yj-c-oo/FPGA_AirDrawing_Video_Processing/v1-framebuffer/uvm/tb_brush_stroke_controller/docs/brush stroke ctrl 모듈 simulation 결과.docx

## 1. 각 테스트 케이스(TC)가 의미하는 것과 트랜잭션 수의 비밀

UVM 환경에서 Total Transactions는 스코어보드에서 compare() 함수가 실행된 횟수입니다. 즉, "하드웨어(DUT)가 실제로 선(Line)을 몇 번 그렸는가?"를 의미합니다.

펜을 뗀 프레임(pen_present = 0)은 하드웨어가 선을 그리지 않고 무시하므로 트랜잭션 개수에서 제외됩니다.

### 1) stroke_basic_test (기본 그리기 검증)

- 의미: 가장 단순한 단일 점(Dot) 그리기를 검증합니다. 시퀀스에서 딱 한 번 펜을 대고 그리는 프레임(pen_present=1, (100, 80))을 인가합니다.
- Total Transactions가 1인 이유: 프레임을 딱 1번 주었고, 하드웨어가 이에 반응해 (100,80) -> (100,80) 경로로 1개의 점을 그렸기 때문에 스코어보드에 1개만 찍힙니다.

### 2) stroke_connect_test (연속 선 그리기 검증)

- 의미: 사용자가 손을 떼지 않고 캔버스에 선을 슥 그리는 상황을 검증합니다. 즉, 이전 좌표와 현재 좌표가 끊어지지 않고 계속 이어지는지(연속 선 생성 로직) 확인하는 데 집중합니다.
- 시퀀스 구성: 아래와 같이 연속으로 4개의 프레임을 줍니다.
  1. Frame 1: (100,100)에 펜 대기
  2. Frame 2: (110,110)으로 이동
  3. Frame 3: (120,120)으로 이동
  4. Frame 4: (130,130)으로 이동
- Total Transactions가 4인 이유: 4번 모두 펜이 눌려있었으므로(pen_present=1), 하드웨어는 다음과 같이 총 4번 선을 그립니다.
  5. 100,100 -> 100,100 (첫 점)
  6. 100,100 -> 110,110 (이전 점과 이음)
  7. 110,110 -> 120,120 (이전 점과 이음)
  8. 120,120 -> 130,130 (이전 점과 이음) 따라서 실제 동작 횟수인 4개가 기록됩니다.

### 3) stroke_penup_test (펜 업/다운 및 초기화 검증)

- 의미: 그리다가 펜을 완전히 떼었다가(pen_present=0), 새로운 곳에 다시 펜을 대고 그릴 때 이전 좌표 버퍼가 잘 초기화되는지 검증합니다. 이전 좌표를 질질 끌고 와서 엉뚱한 사선이 그려지는 하드웨어 버그를 예방합니다.
- 시퀀스 구성: 총 3개의 프레임을 순서대로 줍니다.
  - Frame 1: (100,100)에 그리기 (pen=1)
  - Frame 2: (100,100)에서 손 떼기 (pen=0)
  - Frame 3: (200,200)에 새로 그리기 (pen=1)
- Total Transactions가 2인 이유: 2번째 프레임은 pen=0이라 하드웨어가 아웃풋을 내지 않고 스킵합니다. 따라서 실제로 선을 그린 동작은 Frame 1과 Frame 3 뿐이므로 2개만 트랜잭션으로 잡힙니다.

### 4) stroke_eraser_test & stroke_size_test (지우개 및 브러시 크기 검증)

- 의미:
  - eraser_test: 지우개 모드(sw_eraser=1)일 때 색상이 강제로 투명/검은색(4'b0000)으로 바뀌어 출력되는지 확인합니다.
  - size_test: 브러시 크기 조절(sw_size)에 따라 하드웨어가 렌더링 영역(반경 line_radius, 임계값 line_threshold)을 올바르게 계산해서 굵은 선을 그리는지 확인합니다.
- Total Transactions 수: 시퀀스 내부에서 프레임을 2번씩 쏘아주며, 펜이 모두 눌려있는 상태이므로 각각 2개씩의 동작을 검증하게 됩니다.

### 5) stroke_random_test (무작위 탐색 검증 - 250개)

- 의미: 펜의 상태, 좌표, 색상, 지우개 여부, 크기 등을 무작위($urandom)로 조합하여 하드웨어가 예상치 못한 예외 상황(Corner case)에서 오동작하거나 뻗지 않는지 확인하는 난수 기반 검증입니다.
- Total Transactions가 약 125개 내외인 이유: 시퀀스에서 총 repeat(250) 번 무작위 프레임을 던집니다. 펜 입력 여부(pen_present) 역시 0과 1이 대략 반반 확률로 결정되므로, 실제 펜이 눌려 선이 그려진 평균 125개 내외의 트랜잭션만 스코어보드에 도달하게 됩니다.

### 6) stroke_stress_test (스트레스/부하 검증 - 10000개)

- 의미: 하드웨어에 쉬지 않고 엄청난 양의 데이터를 쏟아부었을 때, 내부 버퍼가 넘치거나(Overflow) 타이밍 프로토콜이 깨지지 않는지 한계 성능을 시험하는 검증입니다.
- 시퀀스 구성: 무려 repeat(10000) 번 동안 연속해서 펜을 대고(pen_present=1) 무작위 좌표를 계속 던집니다.
- Total Transactions가 10000인 이유: 10000번의 프레임 요청 동안 펜을 한 번도 떼지 않고 계속 꾹 눌러 그렸기 때문에 하드웨어가 정직하게 10000번 그리기를 수행하여 10000개의 트랜잭션이 모두 정상 검증됩니다.
