yj-c-oo/FPGA_AirDrawing_Video_Processing/v1-framebuffer/uvm/tb_bbox_center_accum/docs/Bbox coverage 구성.docx

Coverpoint | 검증 내용
cp_position | 중심 / 가장자리 / 모서리 위치
cp_size | Small / Medium / Large 크기
cp_width / cp_height | 가로·세로 길이 구간
cp_pixel_count | Empty / Low / Valid / Huge 픽셀 수
cp_pen_type | Pen 인식 여부 (Threshold 기준)
cp_overflow | 화면 경계 Overflow 검증
cp_erosion | 3픽셀 Noise 제거(침식) 동작

Cross | 검증 목적 | Ignore Bin
cc_pos_size | 위치별 Marker 크기 검증 | Corner + Small 조합 제외 (구조적으로 불가능)
cc_pos_overflow | 위치에 따른 Overflow 검증 | Corner + Normal Overflow 제외 (수학적으로 불가능)
cc_size_type | Marker 크기별 Pen 인식 검증 | 없음
