yj-c-oo/FPGA_AirDrawing_Video_Processing/v1-framebuffer/uvm/tb_bresenham_interpolator/docs/Bresenham Coverage Class 구성.docx

1. Coverpoints

- 좌표 분포 : 시작점/끝점이 화면 전체 영역(좌·중·우 / 상·중·하)에 고르게 분포하는지 검증
- 연산 특성 : dx > dy, dx ≤ dy, dx = dy 조건 검증
- 선 종류 : 수평, 수직, 대각선, 일반 사선 검증
- 선 방향 : 4사분면 및 수평/수직 방향(+/-) 검증
- 선 길이 : Short / Medium / Long / Very Long 구간 검증

2. Cross Coverage

- Line Type × Direction
  - 선 종류별 가능한 방향 조합 검증
  - Ignore Bins 적용으로 불가능한 조합 제외 → 유효 조합만 Coverage 계산
- Line Type × Length
  - 선 종류별 다양한 길이 조합 검증
  - 총 4 × 4 = 16가지 조합 확인

Coverage | 검증 내용
Coordinate Coverage | 시작/끝 좌표가 화면 전체에 고르게 분포하는지 검증
Algorithm Coverage | dx, dy 관계 및 Bresenham 연산 조건 검증
Line Coverage | 선 종류, 방향, 길이 검증
Cross Coverage | 선 종류×방향, 선 종류×길이 조합 검증
Ignore Bins | 발생 불가능한 조합 제외 → 의미 있는 Coverage 측정
