yj-c-oo/FPGA_AirDrawing_Video_Processing/v1-framebuffer/uvm/tb_brush_renderer/docs/BrushRenderer Coverage 구성.docx

① Coverpoints

- Coordinate Coverage
  - X(0~319), Y(0~239)를 3개 영역으로 분할하여 좌표 분포 검증
  - Corner / Border / Center 위치 분류
- Brush Parameter Coverage
  - Radius : SMALL(2~4), MEDIUM(5~8), LARGE(9~11)
  - Threshold : LOW(0~25), NORMAL(26~81), HIGH(82~121)
- Texture & Color Coverage
  - Texture Enable On/Off 및 유효 Texture Shape(0~4) 검증
  - 미지원 Shape(5~7)는 Ignore Bins 적용
  - Color : Transparent, Normal, Texture Color 구분 검증

② Cross Coverage

- Position × Radius
  - 화면 위치별 다양한 브러시 크기 조합 검증
  - Corner + Large Brush 등 극한 조건 포함
- Texture × Color
  - Texture 활성화 상태에서 다양한 색상 조합 검증
  - 예외 조합까지 포함하여 Coverage 확보
