yj-c-oo/FPGA_AirDrawing_Video_Processing/v1-framebuffer/uvm/tb_brush_stroke_controller/docs/Coverage Class 구성.docx

Coverage Class 구성 (UVM Coverage)

1. Input Coverage (input_cg)

- DUT 입력 시나리오가 충분히 검증되었는지 확인
- Pen/Eraser/Size : ON/OFF 상태 커버리지
- Pen Color : 3-bit 컬러(8종) 전체 입력 확인
- Color × Size : 8 × 2 = 16가지 조합 검증
- Pen Present × Eraser : 정상 및 예외 입력 조합 검증

2. Output Coverage (output_cg)

- DUT 출력이 사양에 맞게 생성되는지 확인
- Line Color : 지우개 모드(0000) 및 일반 색상(1000~1111) 검증
- Brush Radius : 2, 3, 5, 7 출력 확인
- Threshold : 6, 12, 25, 49 출력 확인

3. Cross Coverage & Ignore Bins

- 불가능한 조합을 제외하여 의미 있는 Coverage 측정
- Eraser Color + Radius(2,3) → 제외
- Draw Color + Radius(5,7) → 제외
- 하드웨어에서 발생 가능한 조합만 Coverage 계산

Coverage | 검증 내용
Input Coverage | 입력 스위치, 센서값, 색상 및 입력 조합 검증
Output Coverage | 색상, 반경, Threshold 출력 규격 검증
Cross Coverage | 입력 조합 및 출력 조합 검증
Ignore Bins | 하드웨어상 발생 불가능한 조합 제외 → 정확한 Coverage 측정
