yj-c-oo/FPGA_AirDrawing_Video_Processing/v1-framebuffer/uvm/tb_coord_filter/docs/coord coverage 구성.docx

1. 개별 Coverpoint (기본 입력 조건 검증)

하드웨어가 처리 가능한 입력 조건을 균형 있게 검증하기 위한 Coverpoint

Coverpoint | 검증 내용
cp_pen | 펜 상태 (Pen Down / Pen Up)
cp_x | X축 위치 (Left Edge / Center / Right Edge / Middle)
cp_y | Y축 위치 (Top Edge / Center / Bottom Edge / Middle)

2. Cross Coverage (조합 조건 검증)

Cross Coverage | 검증 목적
cross_pen_position (cp_pen × cp_x × cp_y) | 펜의 접촉 여부와 화면 위치를 조합하여 Corner, Center 등 다양한 위치에서 정상적인 좌표 처리 및 잔상 제거 동작 검증

검증 포인트

- Pen Down 상태의 정상 좌표 출력
- Pen Up 상태에서 좌표 초기화 및 잔상(Trash Coordinate) 미출력 확인
- 화면 가장자리와 중앙을 포함한 위치별 동작 검증

3. Motion Classification Coverage (동적 동작 검증)

이전 프레임과의 맨해튼 거리(ΔX + ΔY)를 기준으로 입력 움직임을 분류하여 검증

Motion Class | 조건 | 의미
Stable | 거리 = 0 | 정지 상태
Jitter | 거리 ≤ 5 | 미세 노이즈
Spike | 거리 ≥ 100 | 순간 이동(Glitch)

검증 결과

- 기본 입력 조건(Coverpoint) 검증 완료
- 위치 × 펜 상태(Cross Coverage) 조합 검증 완료
- 정지, 노이즈, 급격한 이동(Motion Classification)까지 포함한 동적 동작 검증 완료
- 극한(Stress) 입력 환경에서도 필터의 예외 처리 및 연산 동작 Coverage 100% 달성
