yj-c-oo/FPGA_AirDrawing_Video_Processing/v1-framebuffer/uvm/tb_bbox_center_accum/docs/bbox coverage 결과 (random test 200회).png

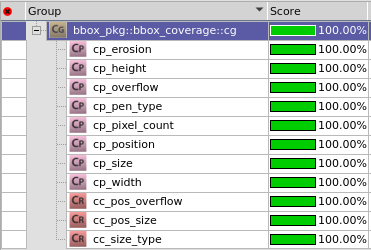
v1-framebuffer/uvm/tb_bbox_center_accum/docs/bbox coverage 결과 (random test 200회).png
