yj-c-oo/FPGA_AirDrawing_Video_Processing/v1-framebuffer/uvm/tb_bresenham_interpolator/docs/Bresenham coverage 결과(random test).png

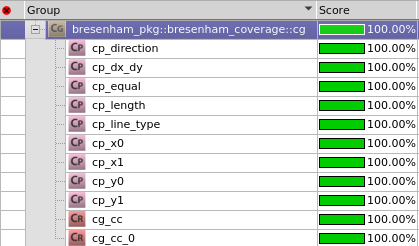
v1-framebuffer/uvm/tb_bresenham_interpolator/docs/Bresenham coverage 결과(random test).png
