yj-c-oo/FPGA_AirDrawing_Video_Processing/v1-framebuffer/uvm/tb_brush_renderer/docs/BrushRenderer coverage 결과 (stress test).png

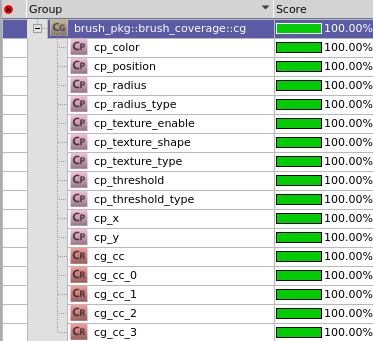
v1-framebuffer/uvm/tb_brush_renderer/docs/BrushRenderer coverage 결과 (stress test).png
