yj-c-oo/FPGA_AirDrawing_Video_Processing/v1-framebuffer/uvm/tb_coord_filter/docs/coord coverage 결과 (random test 200회).png

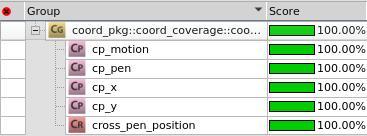
v1-framebuffer/uvm/tb_coord_filter/docs/coord coverage 결과 (random test 200회).png
