yj-c-oo/FPGA_AirDrawing_Video_Processing/v1-framebuffer/vga_uart_project/vga_uart_project.srcs/constrs_1/Basys-3-Master.xdc

## This file is a general .xdc for the Basys3 rev B board
## To use it in a project:
## - uncomment the lines corresponding to used pins
## - rename the used ports (in each line, after get_ports) according to the top level signal names in the project

## Clock signal
set_property -dict { PACKAGE_PIN W5   IOSTANDARD LVCMOS33 } [get_ports clk]
create_clock -add -name sys_clk_pin -period 10.00 -waveform {0 5} [get_ports clk]

## OV7670 camera pixel clock (PCLK). Declared at 25 MHz as a conservative bound.
create_clock -add -name cam_pclk_pin -period 40.00 [get_ports pclk]
## Camera (pclk) and system (clk) domains are asynchronous; the dual-port framebuffer separates them.
set_clock_groups -asynchronous -group [get_clocks -include_generated_clocks sys_clk_pin] -group [get_clocks cam_pclk_pin]


## Switches
## 시스템 리셋 = SW15 (왼쪽 끝). 나머지 스위치는 전부 미사용 (펜 설정은 UART GUI + 버튼).
set_property -dict { PACKAGE_PIN R2    IOSTANDARD LVCMOS33 } [get_ports reset]


## LEDs
#set_property -dict { PACKAGE_PIN U16   IOSTANDARD LVCMOS33 } [get_ports {led[0]}]
#set_property -dict { PACKAGE_PIN E19   IOSTANDARD LVCMOS33 } [get_ports {led[1]}]
#set_property -dict { PACKAGE_PIN U19   IOSTANDARD LVCMOS33 } [get_ports {led[2]}]
#set_property -dict { PACKAGE_PIN V19   IOSTANDARD LVCMOS33 } [get_ports {led[3]}]
#set_property -dict { PACKAGE_PIN W18   IOSTANDARD LVCMOS33 } [get_ports {led[4]}]
#set_property -dict { PACKAGE_PIN U15   IOSTANDARD LVCMOS33 } [get_ports {led[5]}]
#set_property -dict { PACKAGE_PIN U14   IOSTANDARD LVCMOS33 } [get_ports {led[6]}]
#set_property -dict { PACKAGE_PIN V14   IOSTANDARD LVCMOS33 } [get_ports {led[7]}]
#set_property -dict { PACKAGE_PIN V13   IOSTANDARD LVCMOS33 } [get_ports {led[8]}]
#set_property -dict { PACKAGE_PIN V3    IOSTANDARD LVCMOS33 } [get_ports {led[9]}]
#set_property -dict { PACKAGE_PIN W3    IOSTANDARD LVCMOS33 } [get_ports {led[10]}]
#set_property -dict { PACKAGE_PIN U3    IOSTANDARD LVCMOS33 } [get_ports {led[11]}]
#set_property -dict { PACKAGE_PIN P3    IOSTANDARD LVCMOS33 } [get_ports {led[12]}]
#set_property -dict { PACKAGE_PIN N3    IOSTANDARD LVCMOS33 } [get_ports {led[13]}]
#set_property -dict { PACKAGE_PIN P1    IOSTANDARD LVCMOS33 } [get_ports {led[14]}]
#set_property -dict { PACKAGE_PIN L1    IOSTANDARD LVCMOS33 } [get_ports {led[15]}]


##7 Segment Display
#set_property -dict { PACKAGE_PIN W7   IOSTANDARD LVCMOS33 } [get_ports {seg[0]}]
#set_property -dict { PACKAGE_PIN W6   IOSTANDARD LVCMOS33 } [get_ports {seg[1]}]
#set_property -dict { PACKAGE_PIN U8   IOSTANDARD LVCMOS33 } [get_ports {seg[2]}]
#set_property -dict { PACKAGE_PIN V8   IOSTANDARD LVCMOS33 } [get_ports {seg[3]}]
#set_property -dict { PACKAGE_PIN U5   IOSTANDARD LVCMOS33 } [get_ports {seg[4]}]
#set_property -dict { PACKAGE_PIN V5   IOSTANDARD LVCMOS33 } [get_ports {seg[5]}]
#set_property -dict { PACKAGE_PIN U7   IOSTANDARD LVCMOS33 } [get_ports {seg[6]}]

#set_property -dict { PACKAGE_PIN V7   IOSTANDARD LVCMOS33 } [get_ports dp]

#set_property -dict { PACKAGE_PIN U2   IOSTANDARD LVCMOS33 } [get_ports {an[0]}]
#set_property -dict { PACKAGE_PIN U4   IOSTANDARD LVCMOS33 } [get_ports {an[1]}]
#set_property -dict { PACKAGE_PIN V4   IOSTANDARD LVCMOS33 } [get_ports {an[2]}]
#set_property -dict { PACKAGE_PIN W4   IOSTANDARD LVCMOS33 } [get_ports {an[3]}]


##Buttons
## 가운데(btnC)=카메라 시작, 상(btnU)=펜모드 순환, 좌(btnL)=지우개 토글,
## 우(btnR)=clear, 하(btnD)=두께 토글
set_property -dict { PACKAGE_PIN U18   IOSTANDARD LVCMOS33 } [get_ports start_btn]
set_property -dict { PACKAGE_PIN T18   IOSTANDARD LVCMOS33 } [get_ports btn_pen_mode]
set_property -dict { PACKAGE_PIN W19   IOSTANDARD LVCMOS33 } [get_ports btn_eraser]
set_property -dict { PACKAGE_PIN T17   IOSTANDARD LVCMOS33 } [get_ports clear_btn]
set_property -dict { PACKAGE_PIN U17   IOSTANDARD LVCMOS33 } [get_ports btn_pen_size]


##Pmod Header JA
#set_property -dict { PACKAGE_PIN J1   IOSTANDARD LVCMOS33 } [get_ports {JA[0]}];#Sch name = JA1
#set_property -dict { PACKAGE_PIN L2   IOSTANDARD LVCMOS33 } [get_ports {JA[1]}];#Sch name = JA2
#set_property -dict { PACKAGE_PIN J2   IOSTANDARD LVCMOS33 } [get_ports {JA[2]}];#Sch name = JA3
#set_property -dict { PACKAGE_PIN G2   IOSTANDARD LVCMOS33 } [get_ports {JA[3]}];#Sch name = JA4
#set_property -dict { PACKAGE_PIN H1   IOSTANDARD LVCMOS33 } [get_ports {JA[4]}];#Sch name = JA7
#set_property -dict { PACKAGE_PIN K2   IOSTANDARD LVCMOS33 } [get_ports {JA[5]}];#Sch name = JA8
#set_property -dict { PACKAGE_PIN H2   IOSTANDARD LVCMOS33 } [get_ports {JA[6]}];#Sch name = JA9
#set_property -dict { PACKAGE_PIN G3   IOSTANDARD LVCMOS33 } [get_ports {JA[7]}];#Sch name = JA10

##Pmod Header JB
set_property -dict { PACKAGE_PIN A14   IOSTANDARD LVCMOS33 PULLUP TRUE } [get_ports scl];#Sch name = JB1
set_property -dict { PACKAGE_PIN A16   IOSTANDARD LVCMOS33 } [get_ports {vsync}];#Sch name = JB2
#set_property -dict { PACKAGE_PIN B15   IOSTANDARD LVCMOS33 } [get_ports {JB[2]}];#Sch name = JB3
#set_property -dict { PACKAGE_PIN B16   IOSTANDARD LVCMOS33 } [get_ports {JB[3]}];#Sch name = JB4
set_property -dict { PACKAGE_PIN A15   IOSTANDARD LVCMOS33 PULLUP TRUE } [get_ports sda];#Sch name = JB7
set_property -dict { PACKAGE_PIN A17   IOSTANDARD LVCMOS33 } [get_ports {href}];#Sch name = JB8
set_property -dict { PACKAGE_PIN C15   IOSTANDARD LVCMOS33 } [get_ports {xclk}];#Sch name = JB9
set_property -dict { PACKAGE_PIN C16   IOSTANDARD LVCMOS33 } [get_ports {pclk}];#Sch name = JB10

##Pmod Header JC
set_property -dict { PACKAGE_PIN K17   IOSTANDARD LVCMOS33 } [get_ports {pdata[7]}];#Sch name = JC1
set_property -dict { PACKAGE_PIN M18   IOSTANDARD LVCMOS33 } [get_ports {pdata[5]}];#Sch name = JC2
set_property -dict { PACKAGE_PIN N17   IOSTANDARD LVCMOS33 } [get_ports {pdata[3]}];#Sch name = JC3
set_property -dict { PACKAGE_PIN P18   IOSTANDARD LVCMOS33 } [get_ports {pdata[1]}];#Sch name = JC4
set_property -dict { PACKAGE_PIN L17   IOSTANDARD LVCMOS33 } [get_ports {pdata[6]}];#Sch name = JC7
set_property -dict { PACKAGE_PIN M19   IOSTANDARD LVCMOS33 } [get_ports {pdata[4]}];#Sch name = JC8
set_property -dict { PACKAGE_PIN P17   IOSTANDARD LVCMOS33 } [get_ports {pdata[2]}];#Sch name = JC9
set_property -dict { PACKAGE_PIN R18   IOSTANDARD LVCMOS33 } [get_ports {pdata[0]}];#Sch name = JC10

##Pmod Header JXADC
#set_property -dict { PACKAGE_PIN J3   IOSTANDARD LVCMOS33 } [get_ports {JXADC[0]}];#Sch name = XA1_P
#set_property -dict { PACKAGE_PIN L3   IOSTANDARD LVCMOS33 } [get_ports {JXADC[1]}];#Sch name = XA2_P
#set_property -dict { PACKAGE_PIN M2   IOSTANDARD LVCMOS33 } [get_ports {JXADC[2]}];#Sch name = XA3_P
#set_property -dict { PACKAGE_PIN N2   IOSTANDARD LVCMOS33 } [get_ports {JXADC[3]}];#Sch name = XA4_P
#set_property -dict { PACKAGE_PIN K3   IOSTANDARD LVCMOS33 } [get_ports {JXADC[4]}];#Sch name = XA1_N
#set_property -dict { PACKAGE_PIN M3   IOSTANDARD LVCMOS33 } [get_ports {JXADC[5]}];#Sch name = XA2_N
#set_property -dict { PACKAGE_PIN M1   IOSTANDARD LVCMOS33 } [get_ports {JXADC[6]}];#Sch name = XA3_N
#set_property -dict { PACKAGE_PIN N1   IOSTANDARD LVCMOS33 } [get_ports {JXADC[7]}];#Sch name = XA4_N


##VGA Connector
set_property -dict { PACKAGE_PIN G19   IOSTANDARD LVCMOS33 } [get_ports {port_red[0]}]
set_property -dict { PACKAGE_PIN H19   IOSTANDARD LVCMOS33 } [get_ports {port_red[1]}]
set_property -dict { PACKAGE_PIN J19   IOSTANDARD LVCMOS33 } [get_ports {port_red[2]}]
set_property -dict { PACKAGE_PIN N19   IOSTANDARD LVCMOS33 } [get_ports {port_red[3]}]
set_property -dict { PACKAGE_PIN N18   IOSTANDARD LVCMOS33 } [get_ports {port_blue[0]}]
set_property -dict { PACKAGE_PIN L18   IOSTANDARD LVCMOS33 } [get_ports {port_blue[1]}]
set_property -dict { PACKAGE_PIN K18   IOSTANDARD LVCMOS33 } [get_ports {port_blue[2]}]
set_property -dict { PACKAGE_PIN J18   IOSTANDARD LVCMOS33 } [get_ports {port_blue[3]}]
set_property -dict { PACKAGE_PIN J17   IOSTANDARD LVCMOS33 } [get_ports {port_green[0]}]
set_property -dict { PACKAGE_PIN H17   IOSTANDARD LVCMOS33 } [get_ports {port_green[1]}]
set_property -dict { PACKAGE_PIN G17   IOSTANDARD LVCMOS33 } [get_ports {port_green[2]}]
set_property -dict { PACKAGE_PIN D17   IOSTANDARD LVCMOS33 } [get_ports {port_green[3]}]
set_property -dict { PACKAGE_PIN P19   IOSTANDARD LVCMOS33 } [get_ports h_sync]
set_property -dict { PACKAGE_PIN R19   IOSTANDARD LVCMOS33 } [get_ports v_sync]


##USB-RS232 Interface
set_property -dict { PACKAGE_PIN B18   IOSTANDARD LVCMOS33 } [get_ports rx]
set_property -dict { PACKAGE_PIN A18   IOSTANDARD LVCMOS33 } [get_ports tx]


##USB HID (PS/2)
#set_property -dict { PACKAGE_PIN C17   IOSTANDARD LVCMOS33   PULLUP true } [get_ports PS2Clk]
#set_property -dict { PACKAGE_PIN B17   IOSTANDARD LVCMOS33   PULLUP true } [get_ports PS2Data]


##Quad SPI Flash
##Note that CCLK_0 cannot be placed in 7 series devices. You can access it using the
##STARTUPE2 primitive.
#set_property -dict { PACKAGE_PIN D18   IOSTANDARD LVCMOS33 } [get_ports {QspiDB[0]}]
#set_property -dict { PACKAGE_PIN D19   IOSTANDARD LVCMOS33 } [get_ports {QspiDB[1]}]
#set_property -dict { PACKAGE_PIN G18   IOSTANDARD LVCMOS33 } [get_ports {QspiDB[2]}]
#set_property -dict { PACKAGE_PIN F18   IOSTANDARD LVCMOS33 } [get_ports {QspiDB[3]}]
#set_property -dict { PACKAGE_PIN K19   IOSTANDARD LVCMOS33 } [get_ports QspiCSn]


## Configuration options, can be used for all designs
set_property CONFIG_VOLTAGE 3.3 [current_design]
set_property CFGBVS VCCO [current_design]

## SPI configuration mode options for QSPI boot, can be used for all designs
set_property BITSTREAM.GENERAL.COMPRESS TRUE [current_design]
set_property BITSTREAM.CONFIG.CONFIGRATE 33 [current_design]
set_property CONFIG_MODE SPIx4 [current_design]
